9elements/ProgressBar/(threads)

Thread 1 (2022-07-08):

Hardware prototyping

MDr164, 2022-07-08:
This is the umbrella issue for general discussions about the hardware design of the new Progress Bar panel. The plan for a rough design would include an ESP32 as the main MCU combined with a NFC/RFID scanner and potentially a small OLED Display.

**Proposal:**
- MCU: ESP32-C3
- NFC: NXP PN532 or ideally NXP PN7160
- OLED: ???

**TODO:**
Build a prototype design using e.g. a NodeMCU and breakout boards for the components

**HOW TO TEST:**
Very general functionality using example code

PatrickRudolph, 2022-07-11:
**Missing:** Definition of a progress bar panel.
The following questions should be answered as part of the ticket description:
What is it used for?
Who should use it?
Where will it be deployed?
Does it need battery power or is it powered from a power outlet?
Does it need network connection?
The OLED implies that there's an UI. How is the user supposed to interact with the device?
Does it need to be water proof?
What's the expected power usage?
Does it need to idle a lot?
...

MDr164, 2022-07-11:
Update with requested information (will eventually be added to the README once the repo is being filled):

Definition: Small Panel which can scan your RFID chip and register that you just bought a beer. This setup used to exist but was flawed. This endeavor is meant to revive the idea with a more bulletproof design.

What for: Register that a beverage is bought.

Who for: Employees using the ProgressBar.

Where: At the ProgressBar.

Power: Should be powered via 5V or 12V DC, no batteries planned.

Network: Yes, via WiFi (and potentially the Matter protocol)

Interaction: Only via holding the RFID chip to the scanner. The OLED might be used to display how many beverages are already registered to this chip upon scan.

Water proof: Not necessarily, but might be a good idea if feasible.

Power usage: Should not draw too much, but definite numbers don't exist yet.

Idle: Yes, it will idle quite a lot.

Closed 2022-11-20.

Thread 3 (2022-07-11):

Initial Firmware drafts

MDr164, 2022-07-11:
This issue links discussion #2 to track progress on the initial firmware for the device. We should first layout a first draft of this firmware before defining precise issues around it.

**Proposal:**
Using Espressifs ESP-IDF project layout so that we can later on integrate Espressifs ESP-RS and Matter-SDK.

**TODO:**
Plan and discuss the project layout around the firmware and bootstrap/scaffold the initial layout.

**HOW TO TEST:**
Flash initial "Hello, World" or similar on prototype device #1 and verify desired outcome via e.g. serial interface.

Thread 9 (2022-07-22):

Add missing Documentation

MDr164, 2022-07-22:
In the current state there is no documentation present. As the prototyping phase is already at a point where most crucial parts are fixed we should start adding documentation to ease development.

Closed 2022-10-14.

Thread 14 (2022-10-14):

Create schematics for initial device version

MDr164, 2022-10-14:
As the prototype tracked via #1 is mostly done we can move on to incorporating the design into a single PCB for the second round of prototyping. The device should match following criteria:

- Use ESP32C3-Mini-1-N4 or comparable
- Have PN7160/1 directly on the PCB including built-in antenna
- Have USB-C for power (and maybe programming)
- Have extension pins for add-ons (GPIO breakout)

Closed 2022-11-20.
