9elements/ProgressBar/(commit log)

2022-10-14 feat: add project Kconfig
    *add Kconfig.projbuild
    *add i2c default config to Kconfig.projbuild
2022-10-14 fix: update gitignores to reflect current code base
2022-11-20 feat: add initial schematic design
    [progressbar.kicad_pcb, progressbar.kicad_sch]
2022-11-20 feat: add basic Antenna Layout
    [progressbar.kicad_sch]
2022-11-20 feat: replace ESP32-C3 with ESP32-C3 Mini module
    I have some of the ESP32-C3 lying around.
    Makes sense to use them instead of buying new ones.
    Also simplifies the circuit.
    [progressbar.kicad_sch]
2022-11-20 feat: add PCB Layout
    [progressbar.kicad_pcb, progressbar.kicad_sch]
2022-11-27 feat: switch from goreleaser to semantic-release
    Using semantic-release is easier to do on non-go codebases.
2022-12-02 fix: pin dagger action versions
2022-12-08 feat: add ARGB LED
    [progressbar.kicad_pcb, progressbar.kicad_sch]
2022-12-08 fix: use correct SPI size
2023-05-08 feat: refactor for handsoldering
    - Add second RGB LED
    - Refactor to make handsoldering easier
    - Update PN1760 Symbol to get rid of warnings
    [progressbar.kicad_pcb, progressbar.kicad_sch]
2023-05-08 fix: do not use boot strapping pins
    Switched I2C_SCL pin from GPIO8 to GPIO6 because GPIO8 is a boot
    strapping pin and using it for I2C_SCL could potentially make the
    ESP32-C3 unable to flash.
    Also added a Reset Button in case it doesn't work to flash over USB,
    although it should.
    [progressbar.kicad_pcb, progressbar.kicad_sch]
2023-05-08 refactor: update to kicad version 7
    [progressbar.kicad_pcb, progressbar.kicad_sch]
